myriadrf/lc-clock/csad10/CSAD10.step

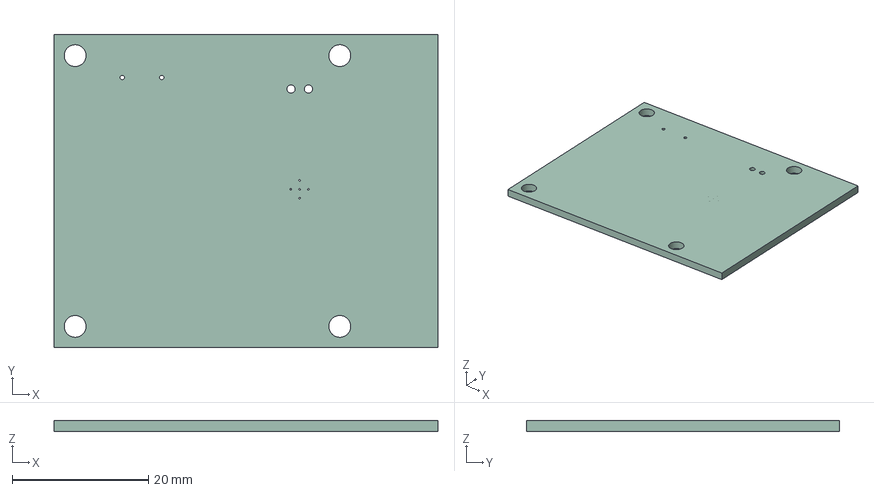
[picture p2: CAD file, 2023-08-11]
csad10/CSAD10.step
56.3 x 45.9 x 1.59 mm
