myriadrf/lc-clock/csad2/CSAD2.step

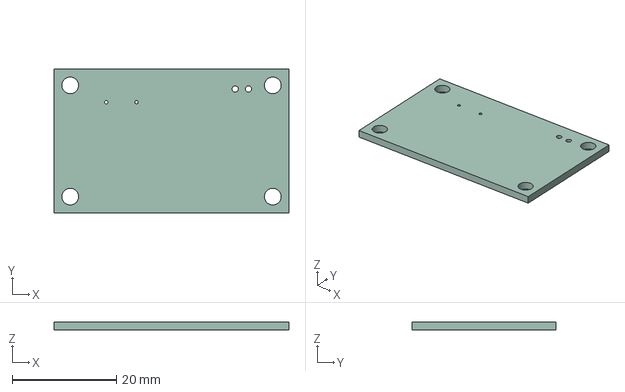
[picture p3: CAD file, 2023-08-11]
csad2/CSAD2.step
45.0 x 27.5 x 1.59 mm
