myriadrf/lc-clock/csad10/Outputs/CSAD10.pdf

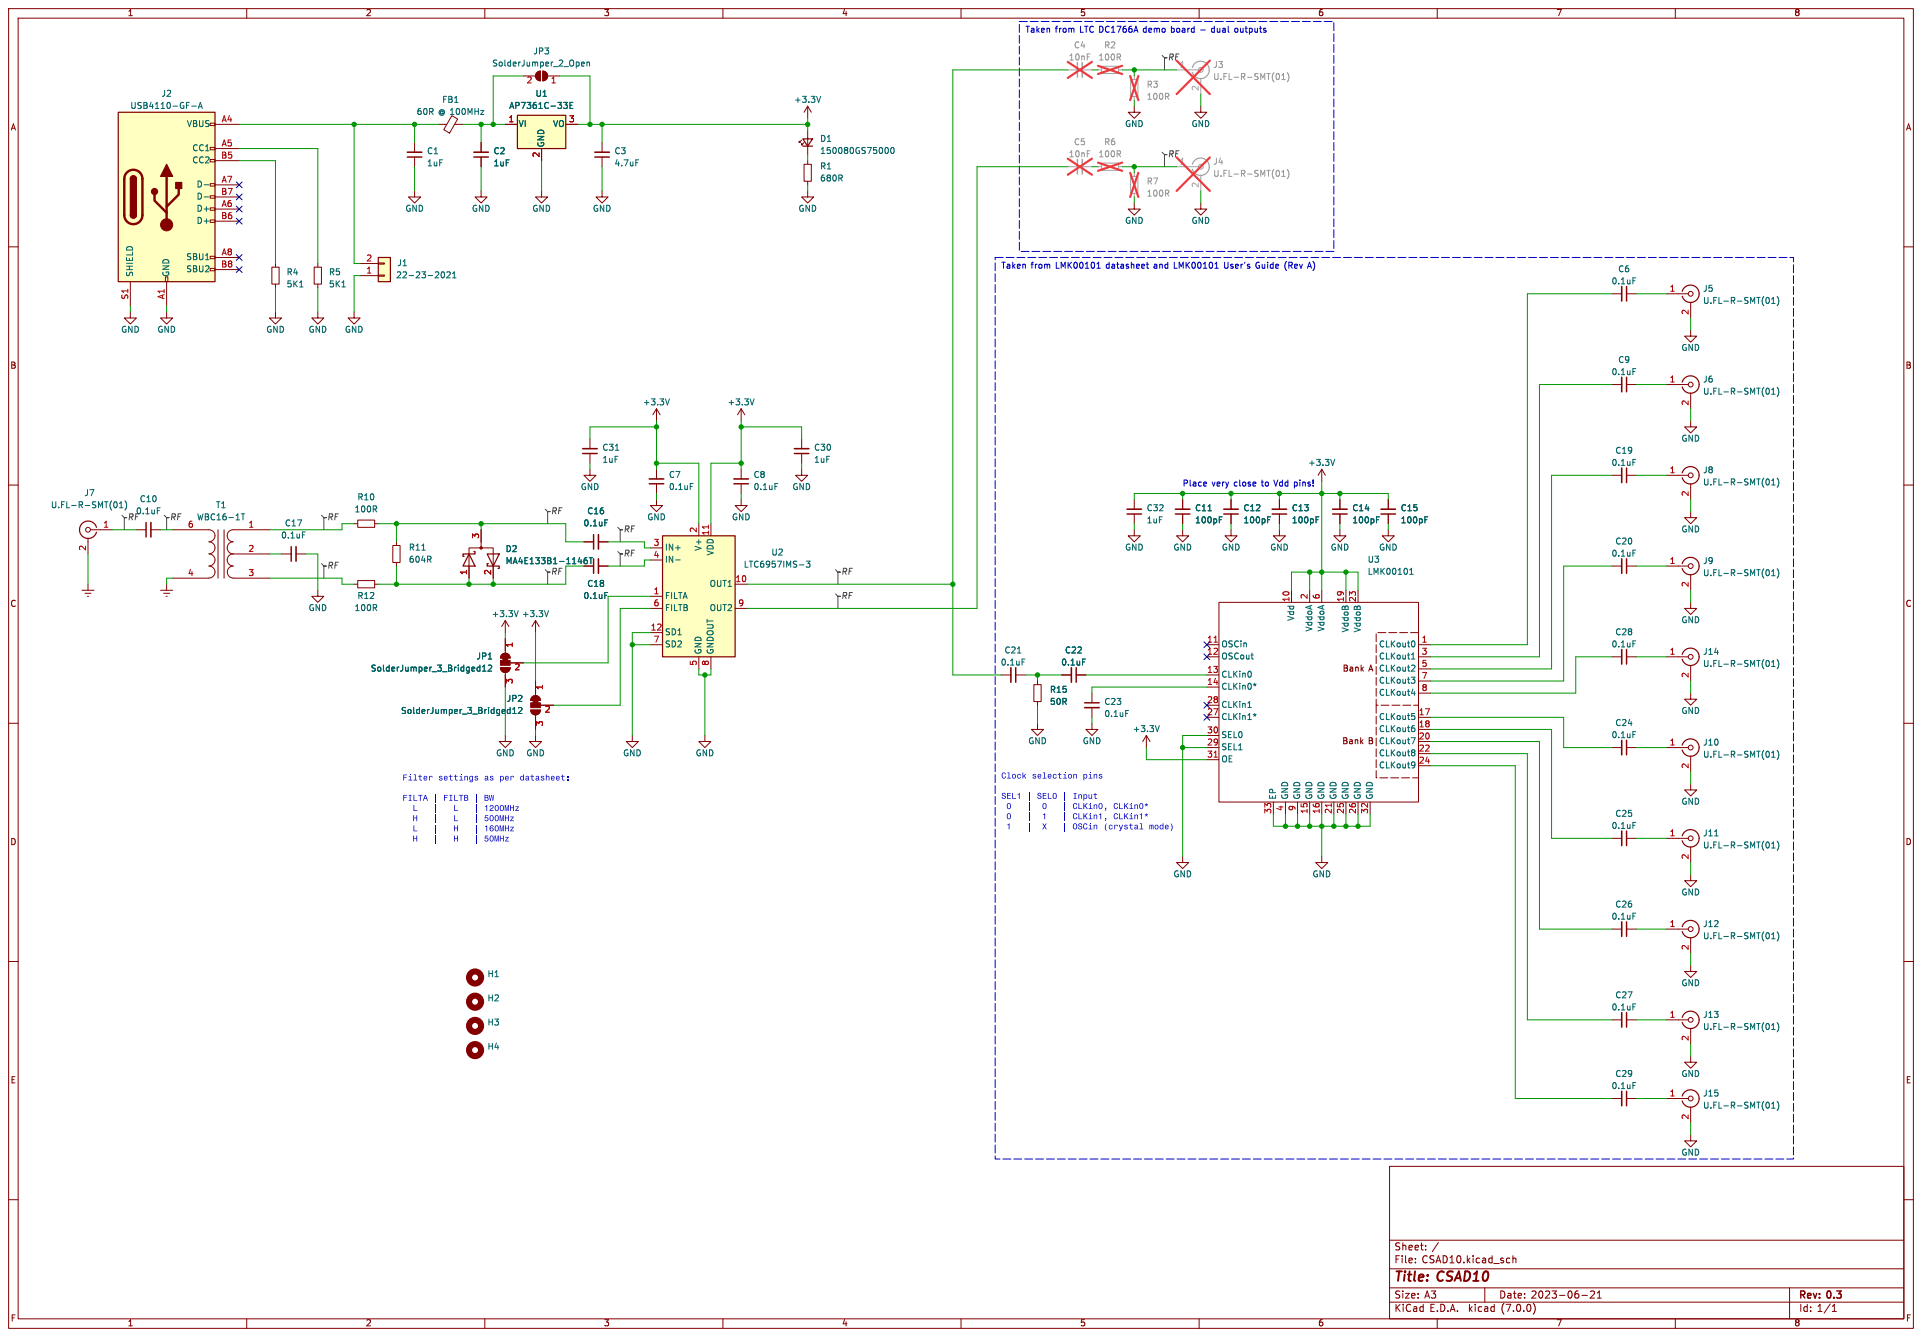
[picture p4: page 1]

Taken from LTC DC1766A demo board - dual outputs

Taken from LMK00101 datasheet and LMK00101 User's Guide (Rev A) Place very close to Vdd pins!

J8U.FL-R-SMT(01) GND GND

2 CLKout7 20 GND 21 CLKout8 22 VddoB 23 CLKout9 24 GND 25 GND 26 CLKin1* 27 CLKin1 28 SEL1 29 CLKout1 3 SEL0 30 OE 31 GND 32 EP 33 GND
