myriadrf/lc-clock/csad10/CSAD10.kicad_pcb

## KiCad design csad10/CSAD10.kicad_pcb (2023-08-11)

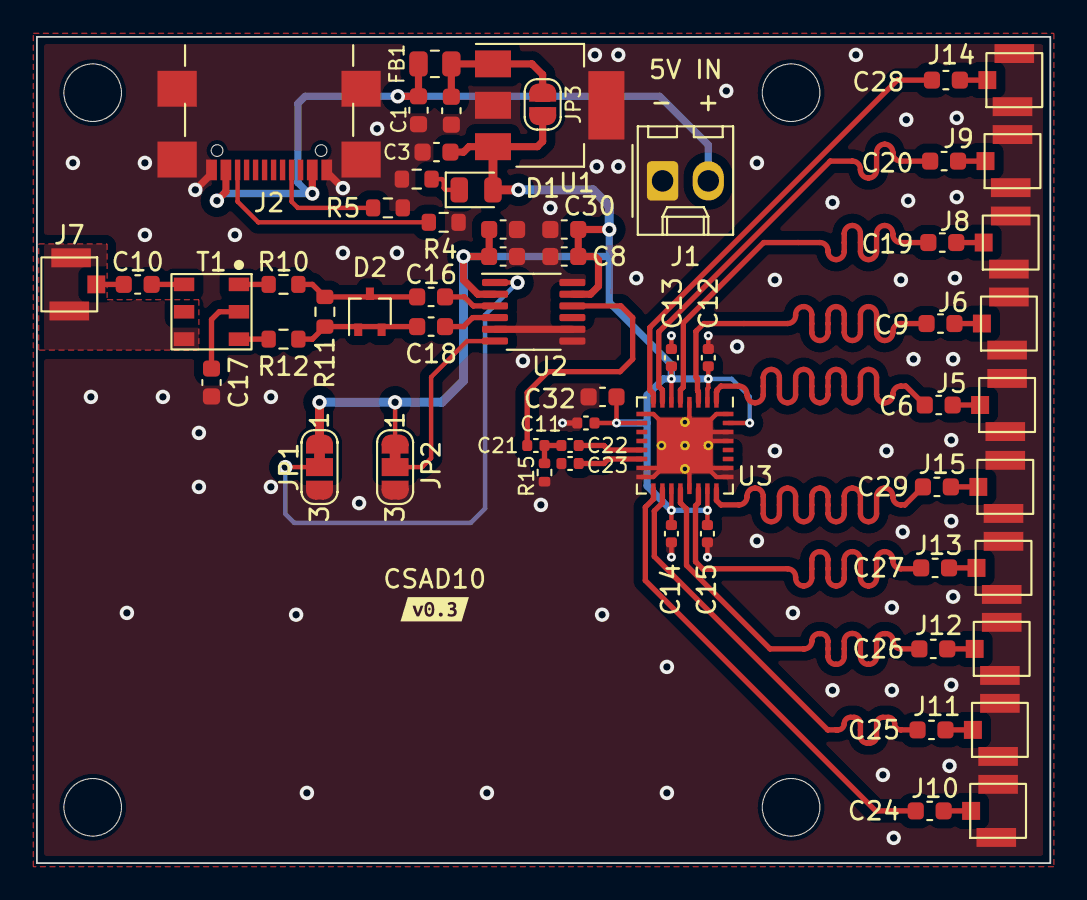
[picture p5: board CSAD10.kicad_pcb from above]

Board: 4 copper layers, 56.3 x 45.9 mm, 65 parts (0 on the bottom side), 43 nets.

Parts:
C1, C2, C30, C31, C32: 1uF; C_0603_1608Metric
C3: 4.7uF; C_0603_1608Metric
C6, C7, C8, C9, C10, C16, C17, C18, C19, C20, C24, C25, C26, C27, C28, C29: 0.1uF; C_0603_1608Metric
C11, C12, C13, C14, C15: 100pF; C_0402_1005Metric
C21, C22, C23: 0.1uF; C_0402_1005Metric
D1: 150080GS75000; LED_0805_2012Metric
D2: MA4E133B1-1146T; SOT-323_SC-70
FB1: 60R @ 100MHz; R_0805_2012Metric
H1, H2, H3, H4: MountingHole; MountingHole_3.2mm_M3_ISO7380
J1: 22-23-2021; Molex_KK-254_AE-6410-02A_1x02_P2.54mm_Vertical
J2: USB4110-GF-A; USB_C_Receptacle_GCT_USB4110-xx-A_16P_TopMnt_Horizontal
J5, J6, J7, J8, J9, J10, J11, J12, J13, J14, J15: U.FL-R-SMT(01); Connector_RF_Hirose_U.FL-R-SMT(01)
JP1, JP2: SolderJumper_3_Bridged12; SolderJumper-3_P1.3mm_Bridged12_RoundedPad1.0x1.5mm_NumberL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
JP3: SolderJumper_2_Open; SolderJumper-2_P1.3mm_Open_RoundedPad1.0x1.5mm
R1: 680R; R_0603_1608Metric
R4, R5: 5K1; R_0603_1608Metric
R10, R12: 100R; R_0603_1608Metric
R11: 604R; R_0603_1608Metric
R15: 50R; R_0402_1005Metric
T1: WBC16-1T; Transformer_Coilcraft_WBC_Series
U1: AP7361C-33E; SOT-223-3_TabPin2
U2: LTC6957IMS-3; MSOP-12_3x4mm_P0.65mm
U3: LMK00101; WQFN-32-1EP_5x5mm_P0.5mm_EP3.1x3.1mm_ThermalVias
kibuzzard-6492A46E: G***; kibuzzard-6492A46E

Connections:
+3.3V: C3.2, C7.2, C8.2, C11.2, C12.2, C13.2, C14.2, C15.2, C30.2, C31.2, C32.2, D1.2 (A), JP1.1 (A), JP2.1 (A), JP3.1 (A), U1.3 (VO), U2.2 (V+), U2.11 (VDD), U3.2 (VddoA), U3.6 (VddoA), U3.10 (Vdd), U3.19 (VddoB), U3.23 (VddoB), U3.31 (OE)
Earth: J7.2 (Ext), T1.4 (AB)
GND: C1.1, C2.1, C3.1, C7.1, C8.1, C11.1, C12.1, C13.1, C14.1, C15.1, C17.2, C23.2, C30.1, C31.1, C32.1, J1.1, J2.A1 (GND), J2.A12 (GND), J2.B1 (GND), J2.B12 (GND), J2.S1 (SHIELD), J5.2 (Ext), J6.2 (Ext), J8.2 (Ext), J9.2 (Ext), J10.2 (Ext), J11.2 (Ext), J12.2 (Ext), J13.2 (Ext), J14.2 (Ext), J15.2 (Ext), JP1.3 (B), JP2.3 (B), R1.2, R4.1, R5.1, R15.1, U1.2 (GND), U2.5 (GND), U2.7 (SD2), U2.8 (GNDOUT), U2.12 (SD1), U3.4 (GND), U3.9 (GND), U3.15 (GND), U3.16 (GND), U3.21 (GND), U3.25 (GND), U3.26 (GND), U3.29 (SEL1), U3.30 (SEL0), U3.32 (GND), U3.33 (EP)
unnamed: C18.1, D2.1 (K), D2.2 (K), R11.2, R12.2
unnamed: C21.1, C22.2, R15.2
unnamed: D1.1 (K), R1.1
unnamed: C16.1, D2.3 (A), R10.2, R11.1
unnamed: C1.2, FB1.1, J1.2, J2.A4 (VBUS), J2.A9 (VBUS), J2.B4 (VBUS), J2.B9 (VBUS)
unnamed: J2.A5 (CC1), R5.2
unnamed: J2.B5 (CC2), R4.2
unnamed: C6.1, J5.1 (In)
unnamed: C9.1, J6.1 (In)
unnamed: C10.1, J7.1 (In)
unnamed: C19.1, J8.1 (In)
unnamed: C20.1, J9.1 (In)
unnamed: C24.1, J10.1 (In)
unnamed: C25.1, J11.1 (In)
unnamed: C26.1, J12.1 (In)
unnamed: C27.1, J13.1 (In)
unnamed: C28.1, J14.1 (In)
unnamed: C29.1, J15.1 (In)
unnamed: JP1.2 (C), U2.1 (FILTA)
unnamed: JP2.2 (C), U2.6 (FILTB)
unnamed: C2.2, FB1.2, JP3.2 (B), U1.1 (VI)
unnamed: C10.2, T1.6 (AA)
unnamed: R12.1, T1.3 (SA)
unnamed: R10.1, T1.1 (SB)
unnamed: C17.1, T1.2 (SC)
unnamed: C16.2, U2.3 (IN+)
unnamed: C18.2, U2.4 (IN-)
unnamed: C21.2, U2.10 (OUT1)
unnamed: C22.1, U3.13 (CLKin0)
unnamed: C23.1, U3.14 (CLKin0*)
unnamed: C6.2, U3.1 (CLKout0)
unnamed: C9.2, U3.3 (CLKout1)
unnamed: C19.2, U3.5 (CLKout2)
unnamed: C20.2, U3.7 (CLKout3)
unnamed: C28.2, U3.8 (CLKout4)
unnamed: C24.2, U3.17 (CLKout5)
unnamed: C25.2, U3.18 (CLKout6)
unnamed: C26.2, U3.20 (CLKout7)
unnamed: C27.2, U3.22 (CLKout8)
unnamed: C29.2, U3.24 (CLKout9)
